Flynsky/subGHzTransceiver/hardware/CC1125_Transceiver/libary/misc/3D/USB4940-00-A.stp

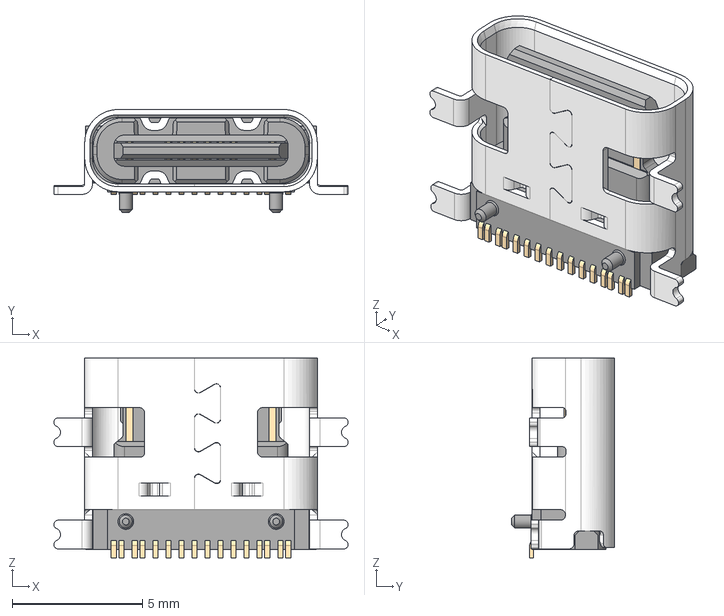
[picture p1: CAD file, 2026-06-12]
hardware/CC1125_Transceiver/libary/misc/3D/USB4940-00-A.stp
11.3 x 3.96 x 7.68 mm
