Flynsky/subGHzTransceiver/hardware/CC1125_Transceiver/libary/misc/3D/ABM8-40.000MHZ-B2-T.stp

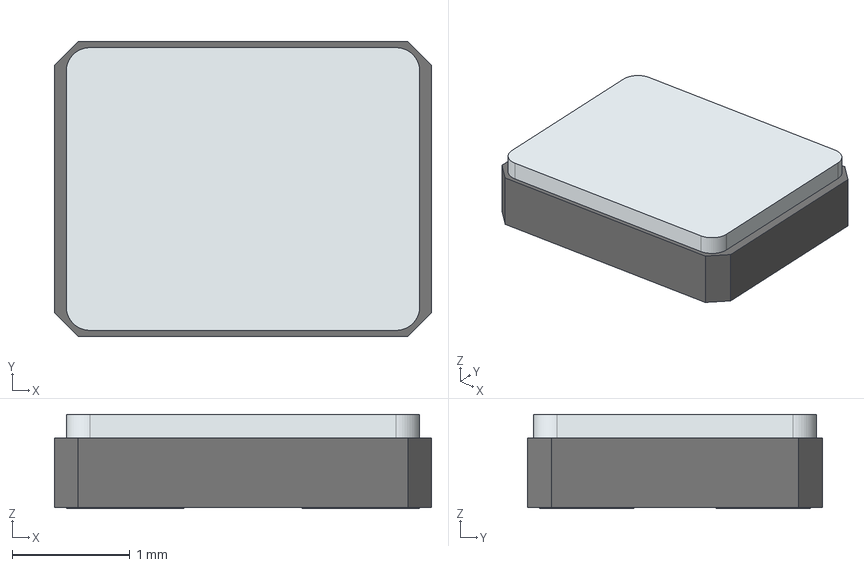
[picture p2: CAD file, 2026-06-12]
hardware/CC1125_Transceiver/libary/misc/3D/ABM8-40.000MHZ-B2-T.stp
3.20 x 2.50 x 0.8 mm
solidBody
solidLid
solidTerminal
