Flynsky/subGHzTransceiver/(notices)

Notices in the files:
hardware/CC1125_Transceiver/libary/misc/3D/USB4940-00-A.stp:
author */ ('License CC BY-ND 4.0'),
